iamtriet/DS-TWR/Tai-lieu-huong-dan/Tai-lieu-huong-dan/Tài liệu hướng dẫn Qorvo.docx

Tài liệu hướng dẫn Qorvo

+Công cụ: STlink
+ Nạp bằng phềm OPENOCD
+ Lệnh để nạp qua OPENOCD:
C:\openocd\bin\openocd.exe(thay bằng đường dẫn thư mục Openocd) -f interface/stlink.cfg -f target/nrf52.cfg ^ -c "init" ^ -c "reset halt" ^ -c "nrf5 mass_erase" ^ -c "program D:/nrf_flash/bootloader.hex verify(đường dẫn bootloader)" ^ -c "program D:/nrf_flash/app.hex(đường dẫn file hex chương trình) verify" ^ -c "reset run" ^ -c "exit"
+ Dùng board Nordic nRF52833 DK (https://adafruit.github.io/arduino-board-index/package_adafruit_index.json)
+ Programmer: Bootloader DFU for Bluefruit nRF52
+File test BNO08x: test_BNO08x.ino
+File test OTA: DWM3001C_OTA_SLOW.ino

+ Giải thích phần khởi tạo để nạp OTA: DFU của Nordic và Qorvo đều không thực hiện OTA trực tiếp trong application mà luôn chuyển quyền điều khiển sang bootloader trước khi cập nhật firmware bằng cách sử dụng hàm enter_dfu_mode(); qua trigger qua UART:

if (Serial1.available()) {

char c = Serial1.read();

DBG("[uart] rx='%c' (0x%02X)\r\n", c, (unsigned)c);

if (c == 'r' || c == 'R') {

enter_dfu_mode();

}

}
