iamtriet/DS-TWR/tools/rmse_timeseries.png

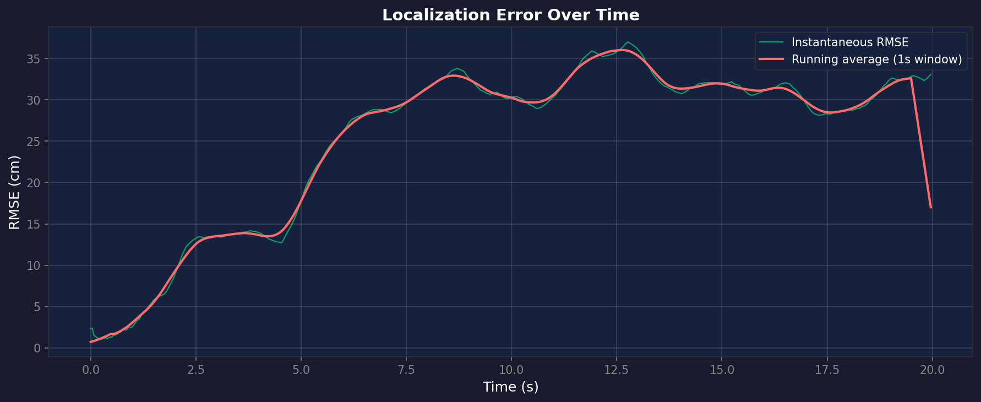
tools/rmse_timeseries.png
