iamtriet/DS-TWR/Cyborg_Debug/BOM/Cyborg greenC_Debug.xlsx

Comment | Description | Designator | Footprint | LibRef | Quantity
JP 2x3 1.27 | Jumper 2x3 1.27mm cái cong | JP1 | JP 2X3 CT 1.27 | JP 2x3 1.27 Cai Thang | 1
CAP SMD 100nF/50V | 0805 Multilayer Ceramic Capacitors MLCC - SMD/SMT ROHS | C1, C2, C4 | CAP CERAMIC SMD 0805 TyPE 2012 | CAP 0805 50V 10% | 3
CAP SMD 100uF | Aluminum Electrolytic Capacitors - Leaded ROHS | C3 | CAP TANTALUM SMD 3528-21 type B | CAP ALU HOLD | 1
S8050 | SOT-23 Bipolar Transistors npn - BJT ROHS | Q1, Q2 | SOT-23 | TRANSISTOR SMD NPN | 2
RES SMD 10K | ±1% - Chip Resistor - Surface Mount ROHS | R1, R2, R3, R4 | RES CHIPS SMD 0805 TYPE 2012 | RES 0805 1% | 4
NC | PAD hàn, không phải linh kiện | R5, R6, R7, R8 | R0402 | RES 0402 | 4
CH340G | Transceiver 2Mbps USB 2.0 SOP-16-150mil USB ICs ROHS | U1 | SOP-16 | IC_CH340G | 1
AMS1117-3.3V |  | U2 | SOT-89 | POWER CONVERTERS AMS117-3V3 - SOT-89 | 1
TYPE-C | 5A 1 16 Female Type-C SMD USB Connectors ROHS | USBC1 | CONNECTORS SMD USB TYPE C 16P | CONNECTORS TYPE-C-31-M-12 | 1
