iamtriet/DS-TWR/Cyborg_Main/DRAW/PCB_Cyborg greenC_Main.step

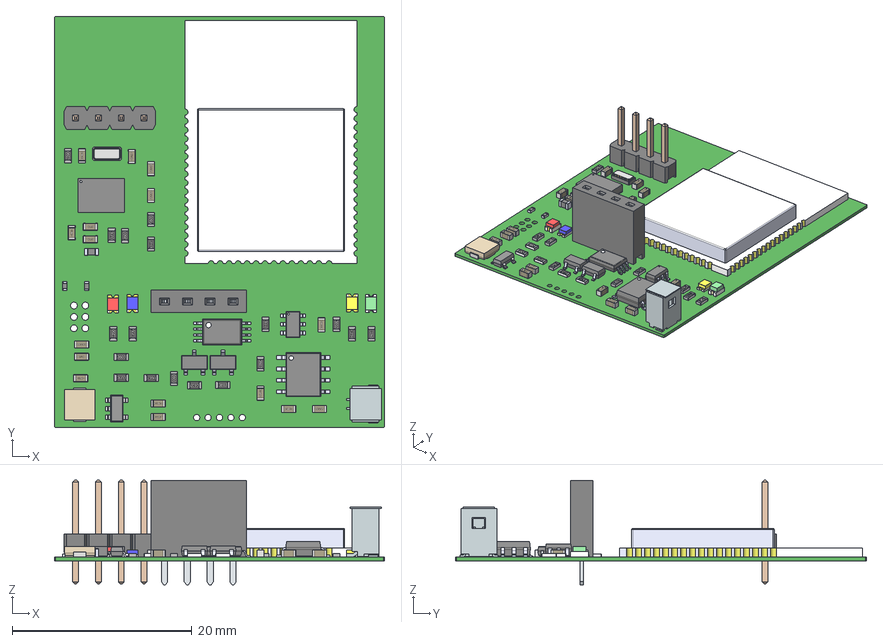
[picture p2: CAD file, 2026-10-12]
Cyborg_Main/DRAW/PCB_Cyborg greenC_Main.step
36.8 x 45.8 x 11.7 mm
6130xx11821_PIN x 4
IND_SRP3012TA_BRN
DWM3001C
CMD17xxx_Green
everlight-17-21-0805LED-YELLOW
everlight-17-21-0805LED-red
everlight-17-21-0805LED-BLUE
Capsule x 18
Encapsulation x 36
TopCover x 18
6130xx11121_PIN x 4
User Library-NDK_NX3215SA
SOT23-5 x 6
ERJU02F5102X x 2
