iamtriet/DS-TWR/Cyborg Green C LED RGB/DRAW/control.step

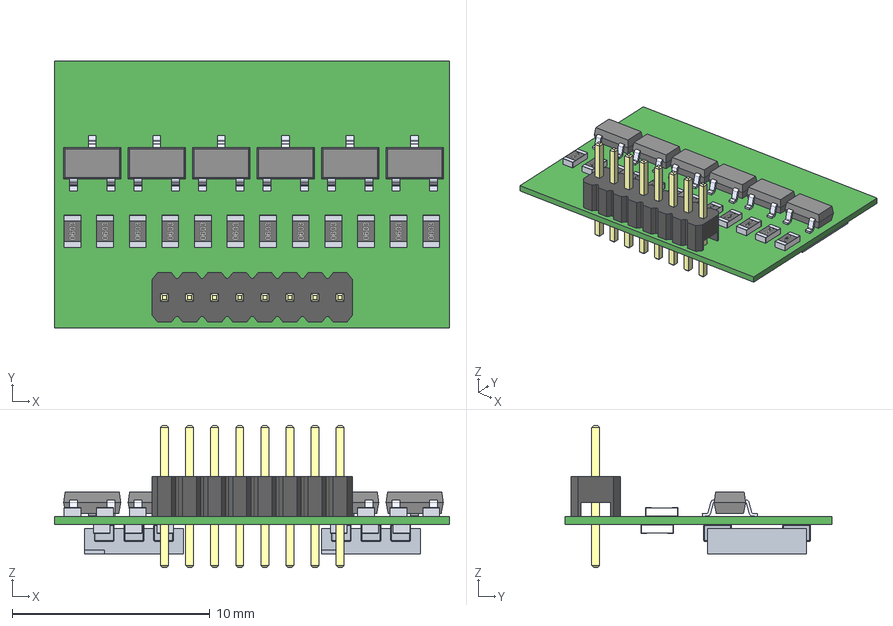
[picture p3: CAD file, 2026-10-12]
Cyborg Green C LED RGB/DRAW/control.step
20.0 x 13.5 x 7.20 mm
User Library-R SMD 0603_0603 BODY x 18
User Library-R SMD 0603_0603 PAD x 36
User Library-R SMD 0603_0603 OPIS x 18
led5050 x 2
HousingBody
Pin1Body
Pin2Body
Pin3Body
Pin4Body
Pin5Body
Pin6Body
Pin7Body
Pin8Body
