iamtriet/DS-TWR/Cyborg Green_C LED UV/DRAW/LED_uv.step

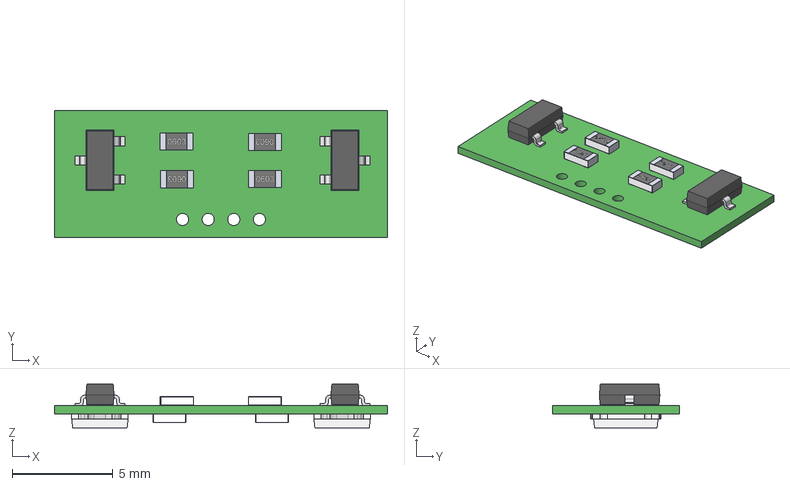
[picture p4: CAD file, 2026-10-12]
Cyborg Green_C LED UV/DRAW/LED_uv.step
16.5 x 6.30 x 2.17 mm
User Library-R SMD 0603_0603 BODY x 6
User Library-R SMD 0603_0603 PAD x 12
User Library-R SMD 0603_0603 OPIS x 6
SW3DPS-SOT-23-DEFAULT x 2
Base x 2
Cover x 2
Glue x 2
Solder x 2
