iamtriet/DS-TWR/MAIN.pdf

Power ORing(Debug_5V/PIN_3.7V) | 2 1

TP4056

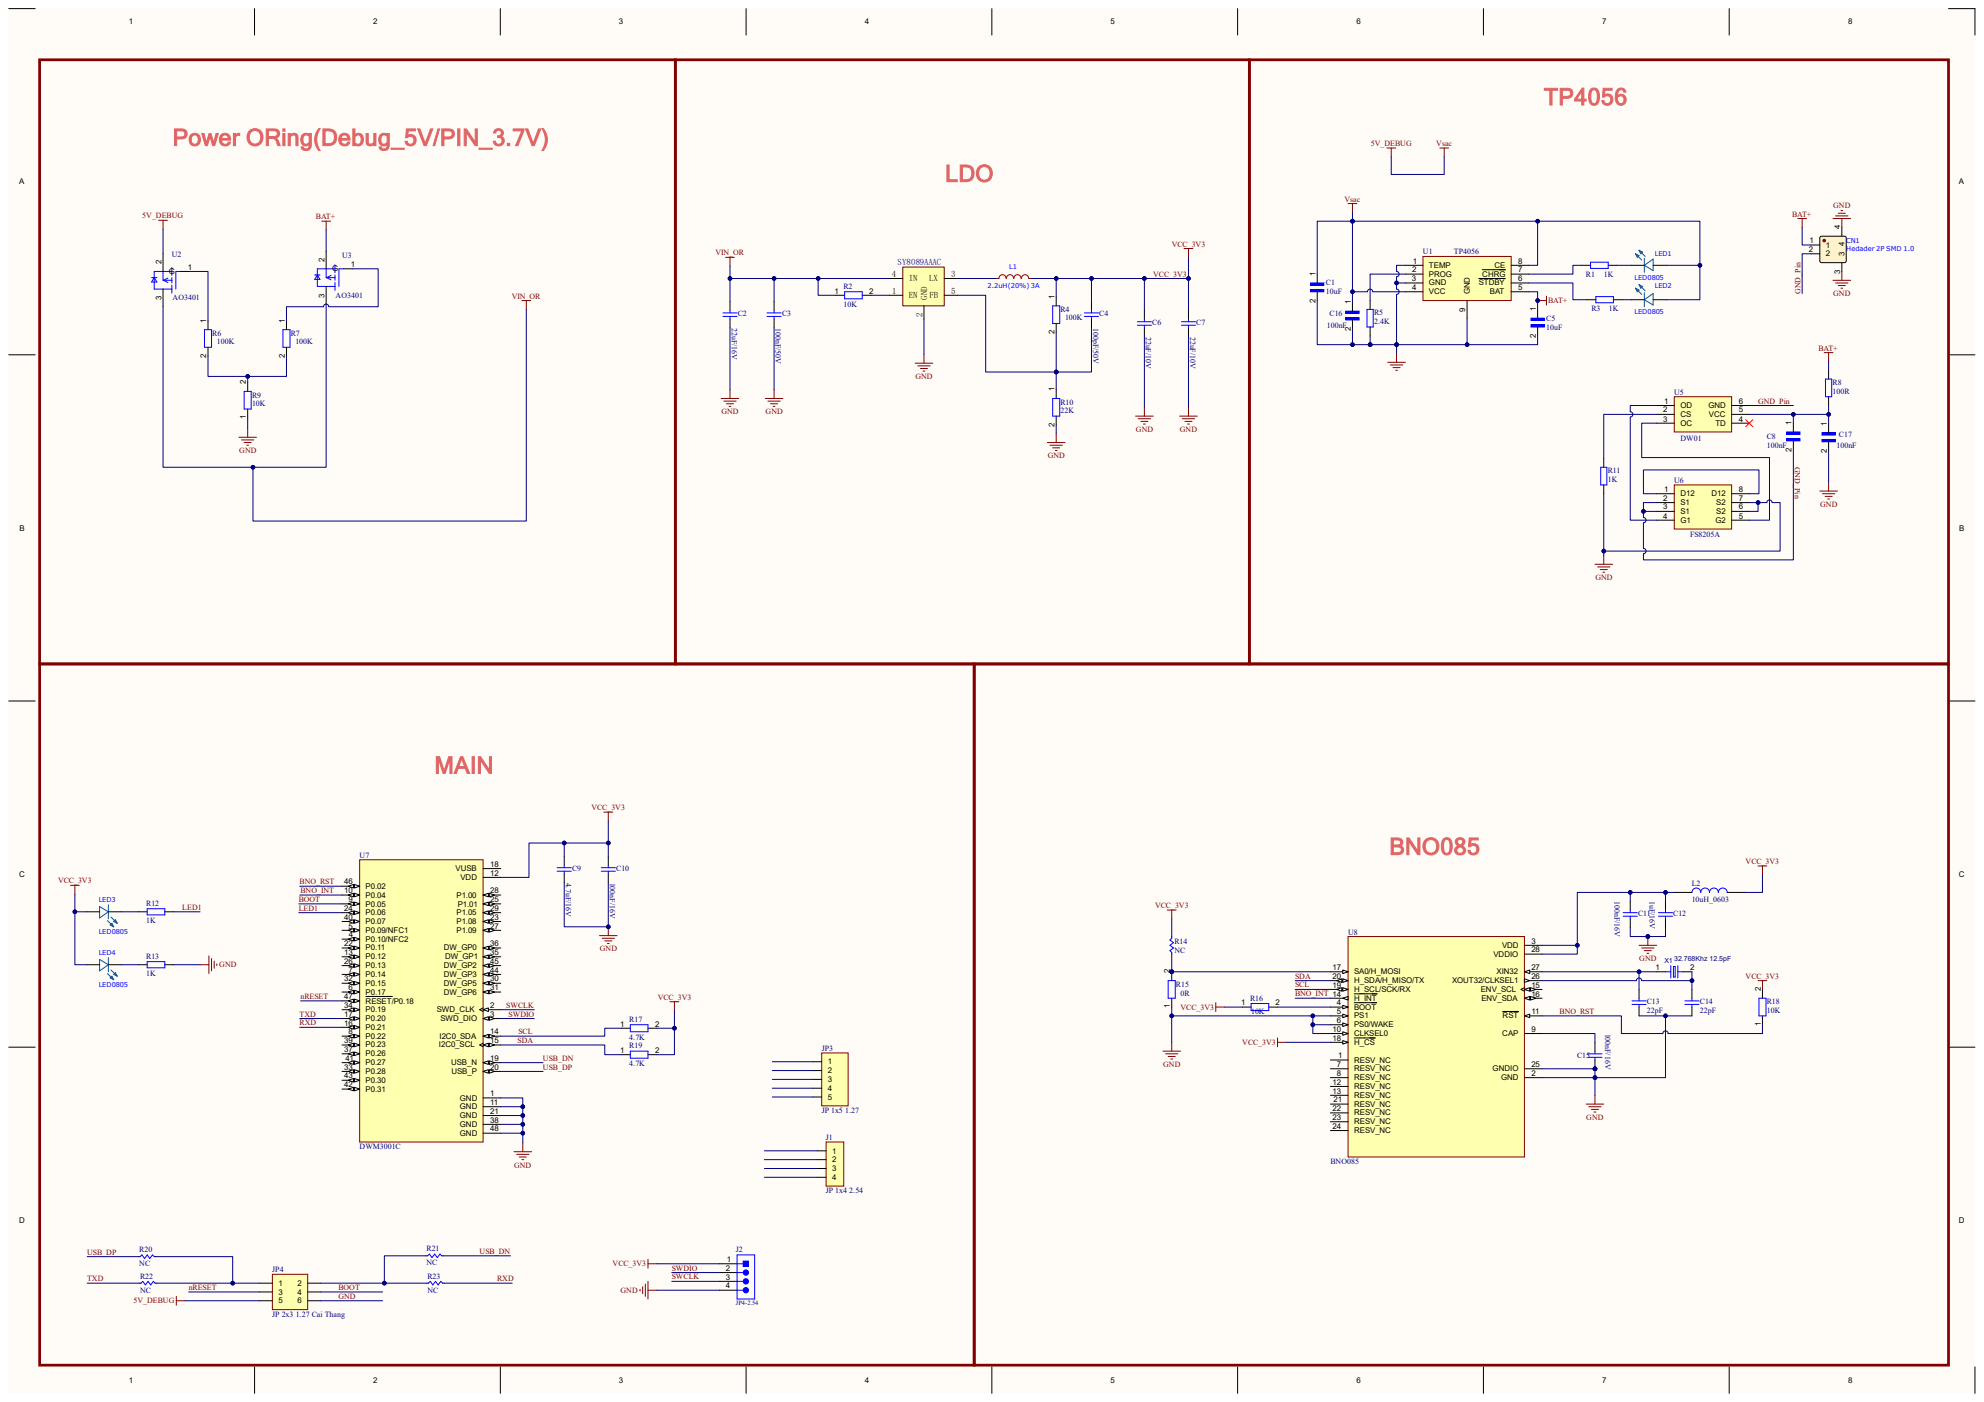
[picture p5: page 1]
