iamtriet/DS-TWR/Cyborg_Debug/DOC/DEBUG.pdf

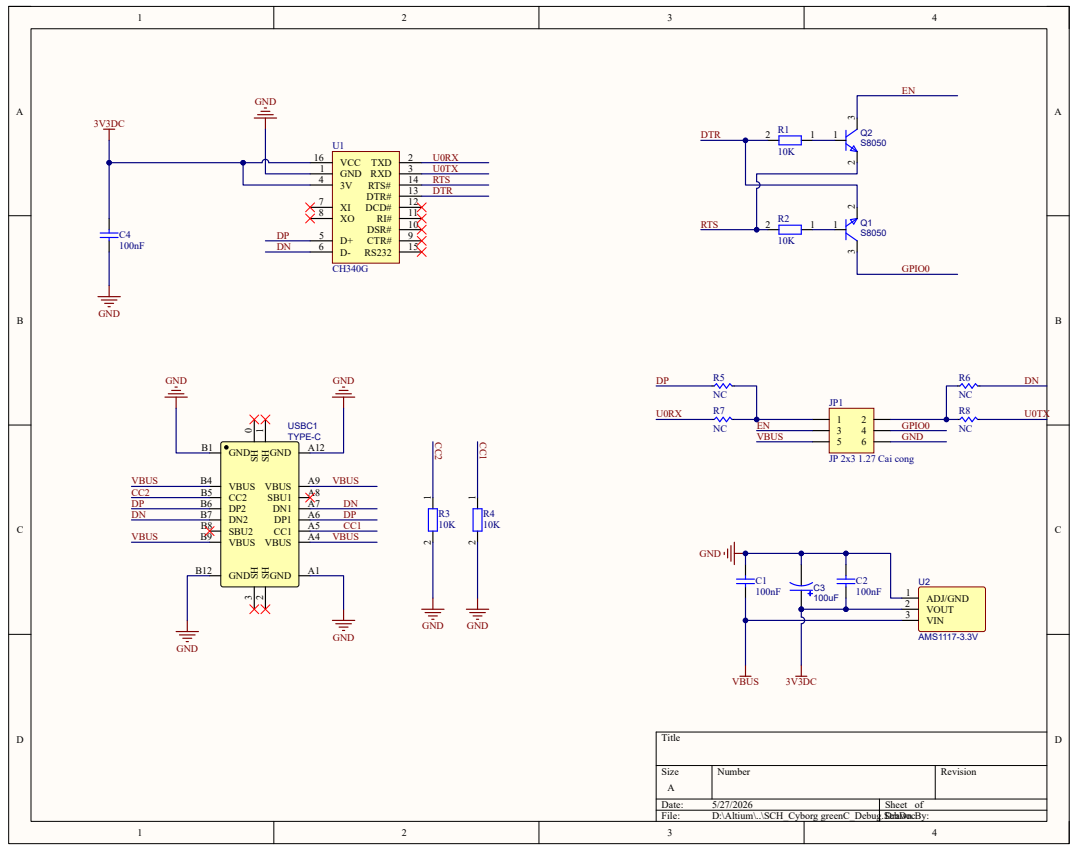
[picture p6: page 1]
