iamtriet/DS-TWR/Cyborg Green C LED RGB/DOC/control.pdf

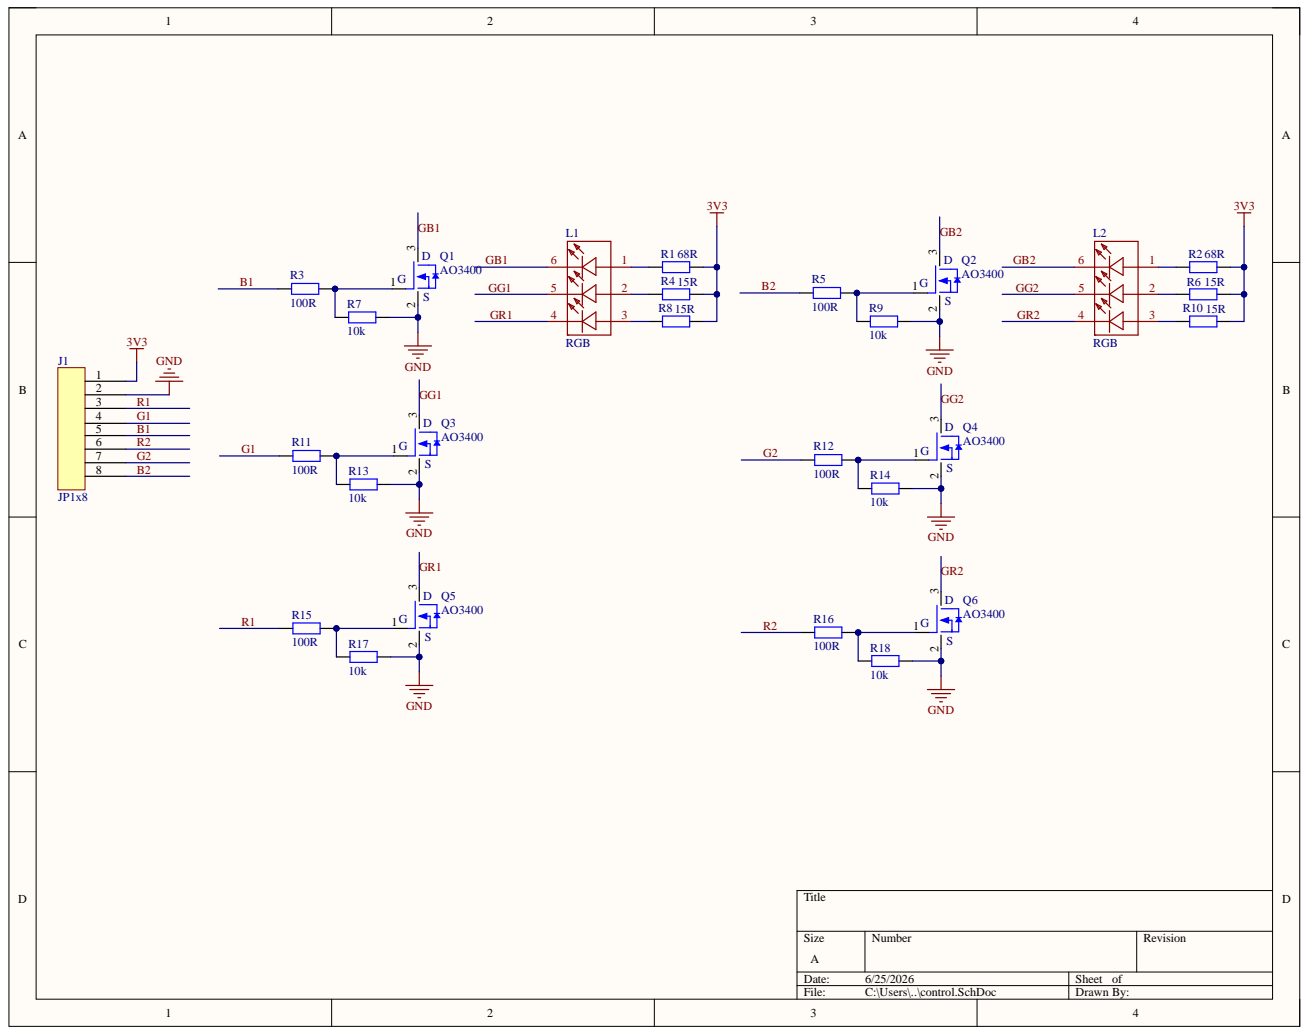
[picture p7: page 1]
