iamtriet/DS-TWR/Cyborg Green_C LED UV/DOC/Custom_LED.pdf

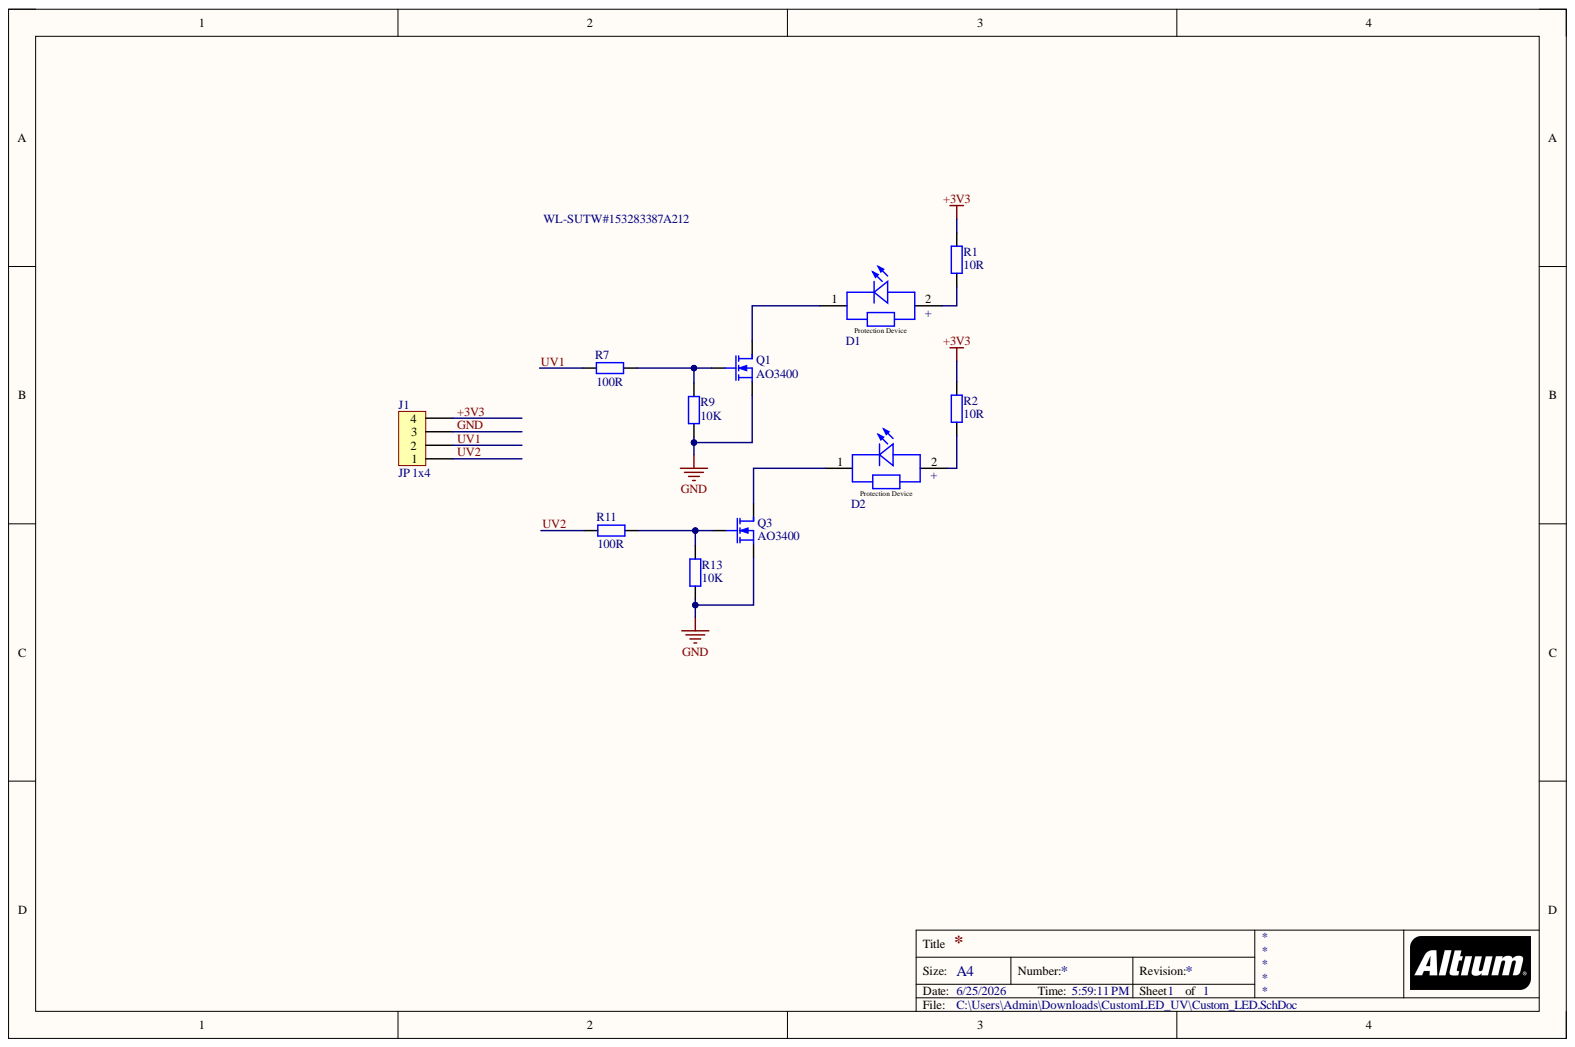
[picture p8: page 1]

* Titl e | **** *

A4 Siz e : | * Numbe r : | * R evision :

Da te : 6/25/202 6 Time : 5:59:11 P M | | She e t 1 o f 1

rs\Admin\Downloads\CustomLED_UV\Cus
