iamtriet/DS-TWR/(list of files, drawings)

Other design files:
Cyborg Green C LED RGB/DRAW/Cyborg_greenC_LED_RGB.PrjPcb
Cyborg Green C LED RGB/DRAW/PCB_Cyborg_greenC_LED_RGB.PcbDoc
Cyborg Green C LED RGB/DRAW/SCH_Cyborg_greenC_LED_RGB.SchDoc
Cyborg Green_C LED UV/DRAW/Cyborg_greenC_LED_UV.PrjPcb
Cyborg Green_C LED UV/DRAW/PCB_Cyborg_greenC_LED_UV.PcbDoc
Cyborg Green_C LED UV/DRAW/SCH_Cyborg_greenC_LED_UV.SchDoc
Cyborg_Debug/DRAW/Cyborg greenC_Debug.PrjPCB
Cyborg_Debug/DRAW/PCB_Cyborg greenC_Debug.PcbDoc
Cyborg_Debug/DRAW/SCH_Cyborg greenC_Debug.SchDoc
Cyborg_Main/DRAW/Cyborg greenC_Main.PrjPcb
Cyborg_Main/DRAW/PCB_Cyborg greenC_Main.PcbDoc
Cyborg_Main/DRAW/Sch_Cyborg greenC_Main.SchDoc
