iamtriet/DS-TWR/(commit log)

2026-10-12 Initial commit: DS-TWR UWB ranging firmware & desktop control system
    Cyborg greenC v001 — DWM3001C (nRF52833 + DW3110) + BNO085 IMU
    Features: DS-TWR ranging, multi-tag tracking, 3D positioning, MCUboot BLE OTA, Tk Control Center, batch OTA for 30 boards, UART CLI, simulation/replay
2026-10-14 feat: DS-TWR anchor-free cooperative localization (30-node TDMA)
    Firmware (C — DWM3001C / nRF52833):
    - dstwr_tdma.h: packet structs, 40-bit timestamp math, DS-TWR constants
    - dstwr_tdma.c: TDMA state machine, NLOS diagnostics, dynamic master
    failover, sniffer binary UART output
    - Integrated into main.c, console.c, uwb_app.c (dstwr start/stop/status)
    - platformio.ini: added [env:dstwr] and [env:dstwr_sniffer] build targets
    Python host localization engine (tools/host_localization_engine.py):
    - AsymmetricDSTWRAssembler: UART binary decode to D, W matrices
    - WeightedSMACOFSolver: vectorized Guttman Transform MDS (101 fps)
    - OpportunisticKabschAligner: ZUPT detection + weighted SVD anti-drif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
2026-10-26 feat: add swarm network, virtual geofencing, motion tracking and comprehensive tooling
    Firmware: swarm broadcast, cooperative ranging, radio/IMU/OTA enhancements, DW3000 patches, aux LED, Zephyr swarm config
    Tools: virtual geofencing, swarm gateway/localization/tracker, live trails, cockroach mapping, region overlay, motion replay/report, range filter, manual LED, OTA batch
    Docs: virtual geofencing, swarm broadcast, reference TDMA, sniffer origin, kalman recovery, motion tracking, node6 continuity/stationary, sparse filtered, manual UV
    Tests: 14 new test scripts for swarm, geofencing, range, motion zones
    Scripts: swarm all mobile, swarm simulation, sniffer origin, virtual geofencing laun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
2026-11-02 feat: enhance swarm tracking, LED control, power optimization and add new tools
    - Add UART discovery and swarm membership tools
    - Add fleet start gate, swarm membership & UART discovery tests
    - Enhance LED tracking view with improved visualization
    - Enhance manual LED view with better UI
    - Update swarm cooperative tracker with extended features
    - Improve swarm gateway reliability
    - Add IMU improvements and swarm timer enhancements
    - Add power optimization documentation
    - Add UWB tracking guide (Vietnamese)
    - Add START_CONTROL_CENTER script
    - Update hardware docs and MANUAL_UV
    - Fix control backend and position gate bugs
